SamuelAkintomide/ARTEx/3Dmodels/Picture17.jpg

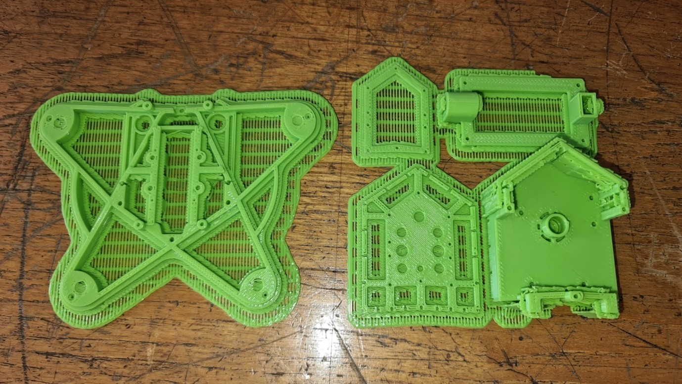
3Dmodels/Picture17.jpg
