SamuelAkintomide/ARTEx/3Dmodels/Picture8.jpg

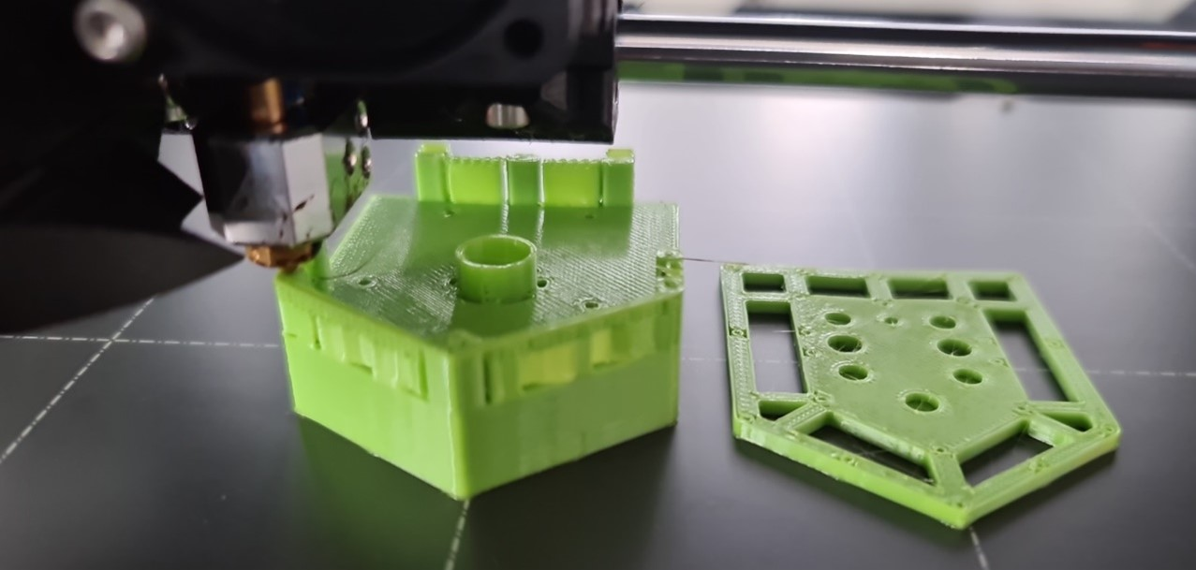
3Dmodels/Picture8.jpg
