SamuelAkintomide/ARTEx/3Dmodels/Picture1.png

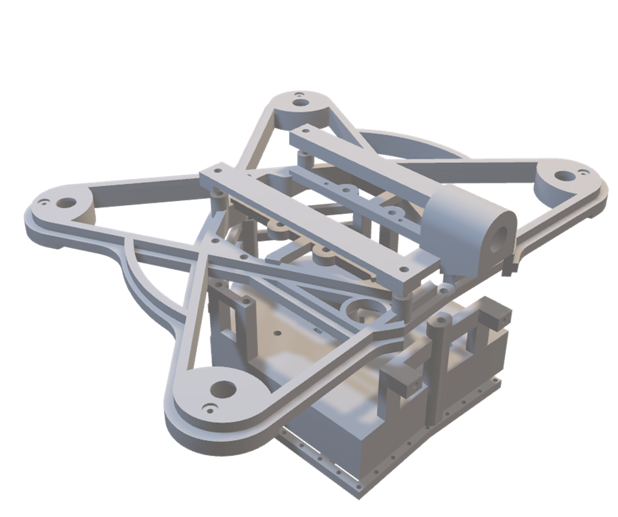
3Dmodels/Picture1.png
