SamuelAkintomide/ARTEx/3Dmodels/Picture2.png

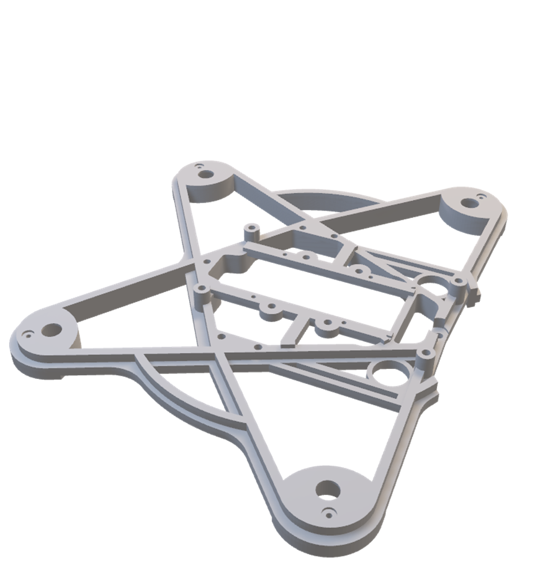
3Dmodels/Picture2.png
