SamuelAkintomide/ARTEx/3Dmodels/Picture3.png

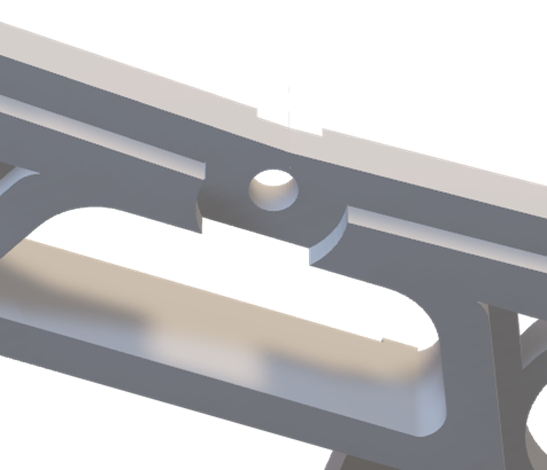
3Dmodels/Picture3.png
