SamuelAkintomide/ARTEx/3Dmodels/Picture4.png

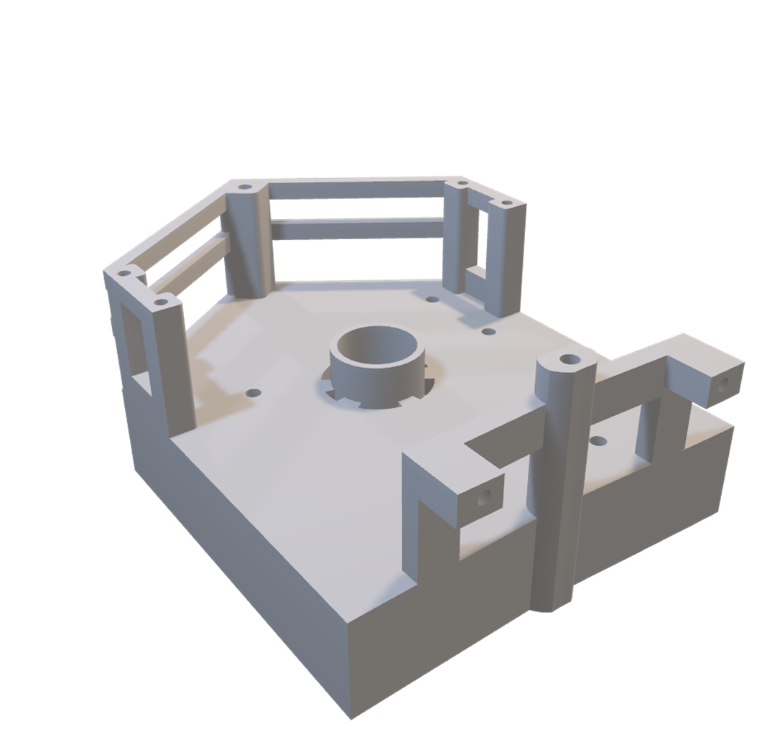
3Dmodels/Picture4.png
