SamuelAkintomide/ARTEx/3Dmodels/Picture5.png

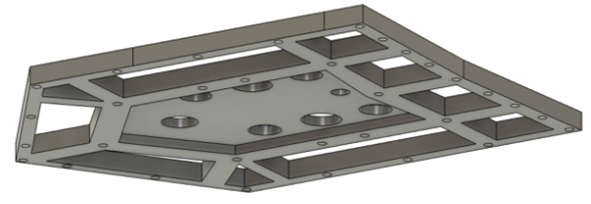
3Dmodels/Picture5.png
