SamuelAkintomide/ARTEx/3Dmodels/Picture6.png

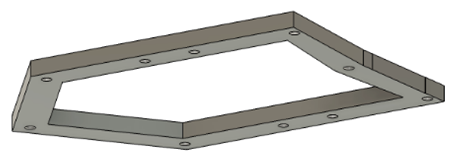
3Dmodels/Picture6.png
