SamuelAkintomide/ARTEx/3Dmodels/Picture7.png

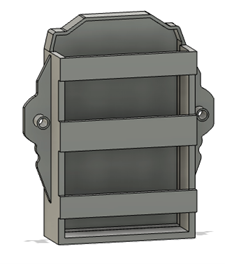
3Dmodels/Picture7.png
